MeesCode/esp-doorbell/srd-05vdc-sl-c.stp

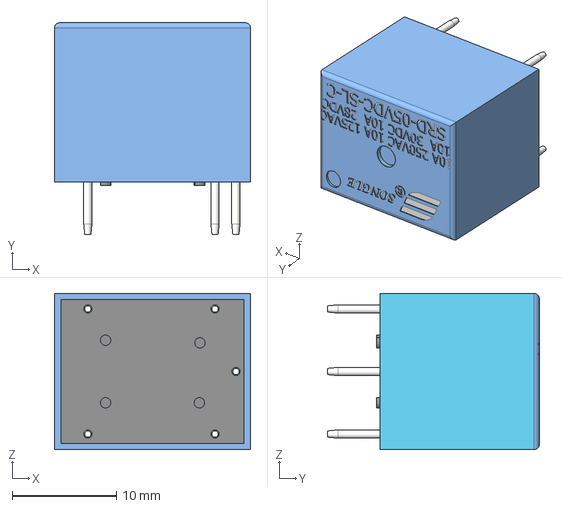
[picture p2: CAD file, 2025-04-24]
srd-05vdc-sl-c.stp
18.8 x 20.3 x 15.0 mm
