MeesCode/esp-doorbell/esp-doorbell.kicad_pcb

## KiCad design esp-doorbell.kicad_pcb (2025-04-26)

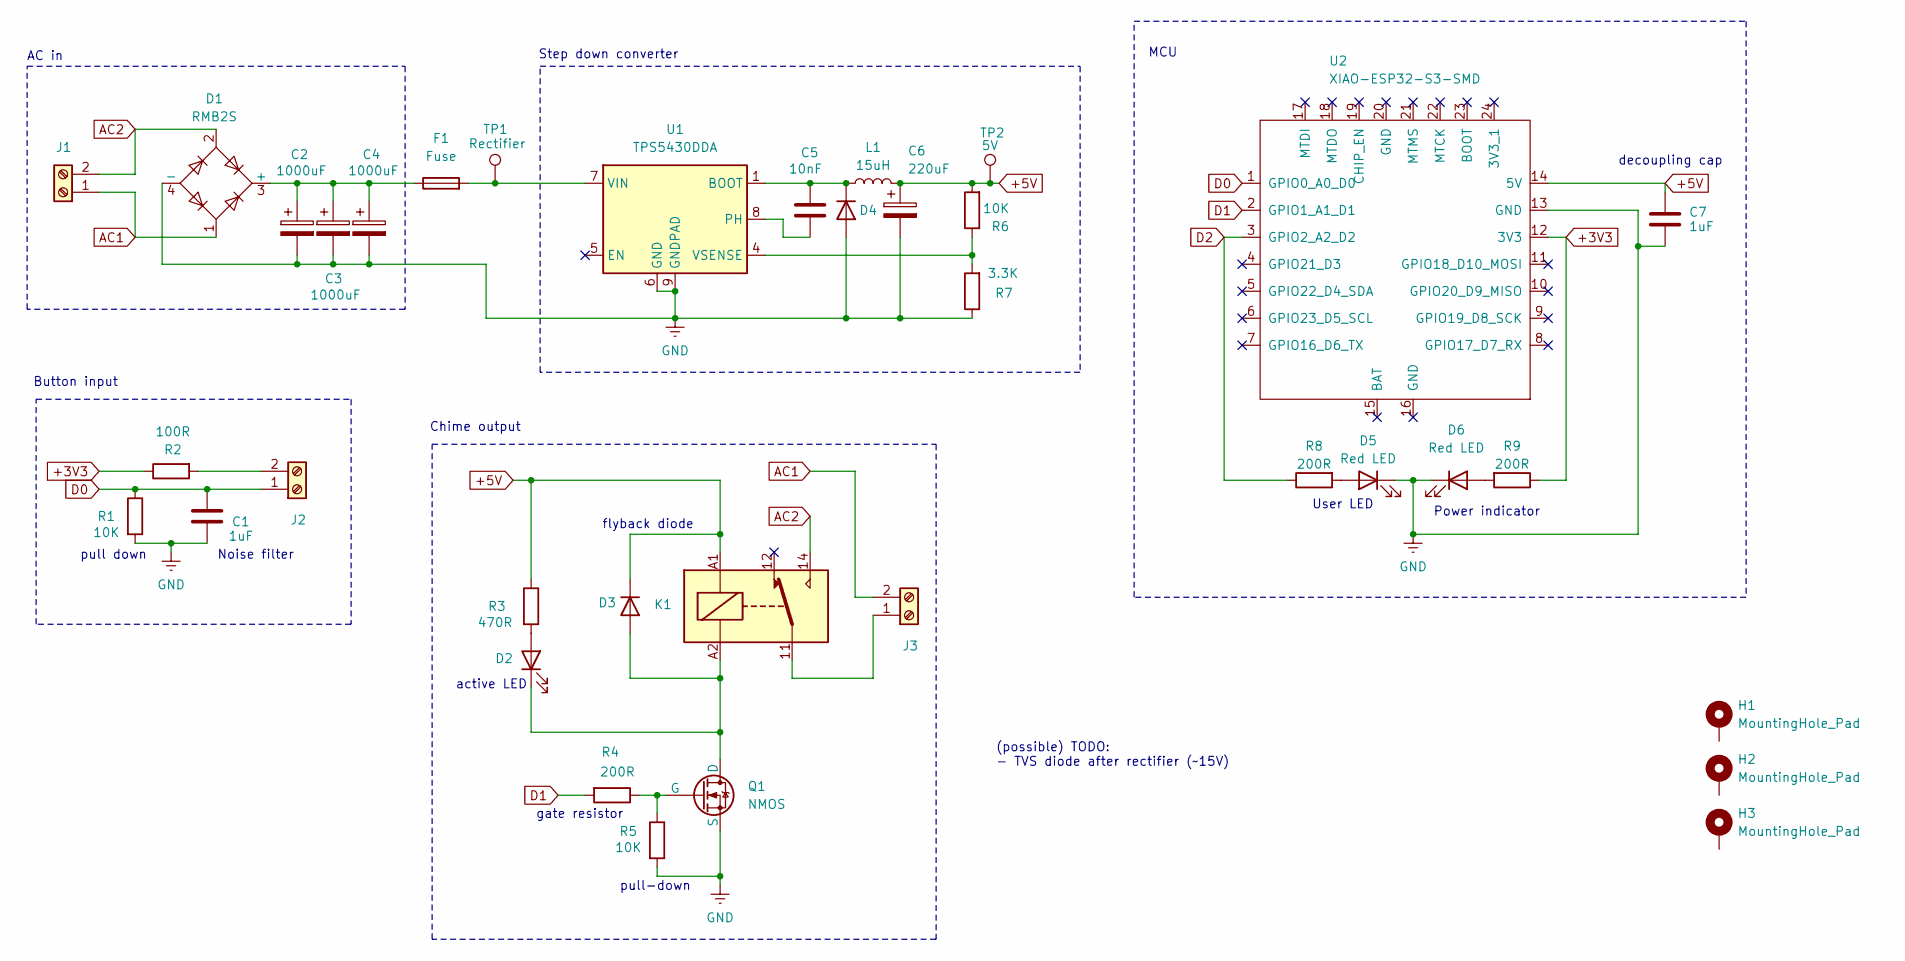
[picture p3: schematic esp-doorbell.kicad_sch]

Parts:
C1, C7: 1uF; C_0402_1005Metric; LCSC C52923
C2, C3, C4: 1000uF; CP_Elec_10x12.5; LCSC C2904877
C5: 10nF; C_0402_1005Metric; LCSC C57112
C6: 220uF; CP_Elec_6.3x7.7; LCSC C3342
D1: RMB2S; TO-269AA; LCSC C2488
D2, D5, D6: Red LED; LED_0603_1608Metric; LCSC C2286
D3: SM4007PL; D_SOD-123F; LCSC C64898
D4: D; D_SMA; Manufacturer # B530C-13-F; LCSC C64982
F1: Fuse; LED_1206_3216Metric; LCSC C720075
H1, H2, H3: MountingHole_Pad; MountingHole_3.2mm_M3_DIN965_Pad
J1, J2, J3: Screw_Terminal_01x02; TerminalBlock_Phoenix_MKDS-1,5-2-5.08_1x02_P5.08mm_Horizont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; LCSC C8465
K1: JQC-3FF-005-1Z; Relay_SPDT_Hongfa_JQC-3FF_0XX-1Z; LCSC C24585
L1: 15uH; L_Changjiang_FNR5040S; LCSC C167969
Q1: NMOS; SOT-23-3; LCSC C20917
R1, R5, R6: 10K; R_0603_1608Metric; LCSC C15401
R2: 100R; R_0603_1608Metric; LCSC C22775
R3: 470R; R_0603_1608Metric; LCSC C23179
R4, R8, R9: 200R; R_0603_1608Metric; LCSC C22962
R7: 3.3K; R_0603_1608Metric; LCSC C22978
TP1: Rectifier; TestPoint_Pad_D1.0mm
TP2: 5V; TestPoint_Pad_D1.0mm
U1: TPS5430DDA; TI_SO-PowerPAD-8_ThermalVias; LCSC C9864
U2: XIAO-ESP32-S3-SMD; XIAO-ESP32C6-SMD

Connections:
+3V3: R2.1, R9.1, U2.12 (3V3)
+5V: C6.1, C7.1, D3.1 (K), K1.A1, L1.2, R3.1, R6.2, TP2.1, U2.14 (5V)
AC1: D1.1, J1.1, J3.2
AC2: D1.2, J1.2, K1.14
D0: C1.1, J2.1, R1.1, U2.1 (GPIO0_A0_D0)
D1: R4.2, U2.2 (GPIO1_A1_D1)
D2: R8.1, U2.3 (GPIO2_A2_D2)
GND: C1.2, C2.2, C3.2, C4.2, C6.2, C7.2, D1.4 (-), D4.2 (A), D5.1 (K), D6.1 (K), Q1.3 (S), R1.2, R5.2, R7.1, U1.6 (GND), U1.9 (GNDPAD), U2.13 (GND)
unnamed: C2.1, C3.1, C4.1, D1.3 (+), F1.1
unnamed: D2.2 (A), R3.2
unnamed: D2.1 (K), D3.2 (A), K1.A2, Q1.1 (D)
unnamed: C5.2, D4.1 (K), L1.1, U1.1 (BOOT)
unnamed: D5.2 (A), R8.2
unnamed: D6.2 (A), R9.2
unnamed: J2.2, R2.2
unnamed: J3.1, K1.11
unnamed: Q1.2 (G), R4.1, R5.1
unnamed: C5.1, U1.8 (PH)
unnamed: F1.2, TP1.1, U1.7 (VIN)
unnamed: R6.1, R7.2, U1.4 (VSENSE)

Notes on the sheet:
active LED
Button input
Noise filter
Chime output
pull down
User LED
AC in
(possible) TODO: - TVS diode after rectifier (~15V)
Power indicator
gate resistor
pull-down
Step down converter
flyback diode
decoupling cap
MCU

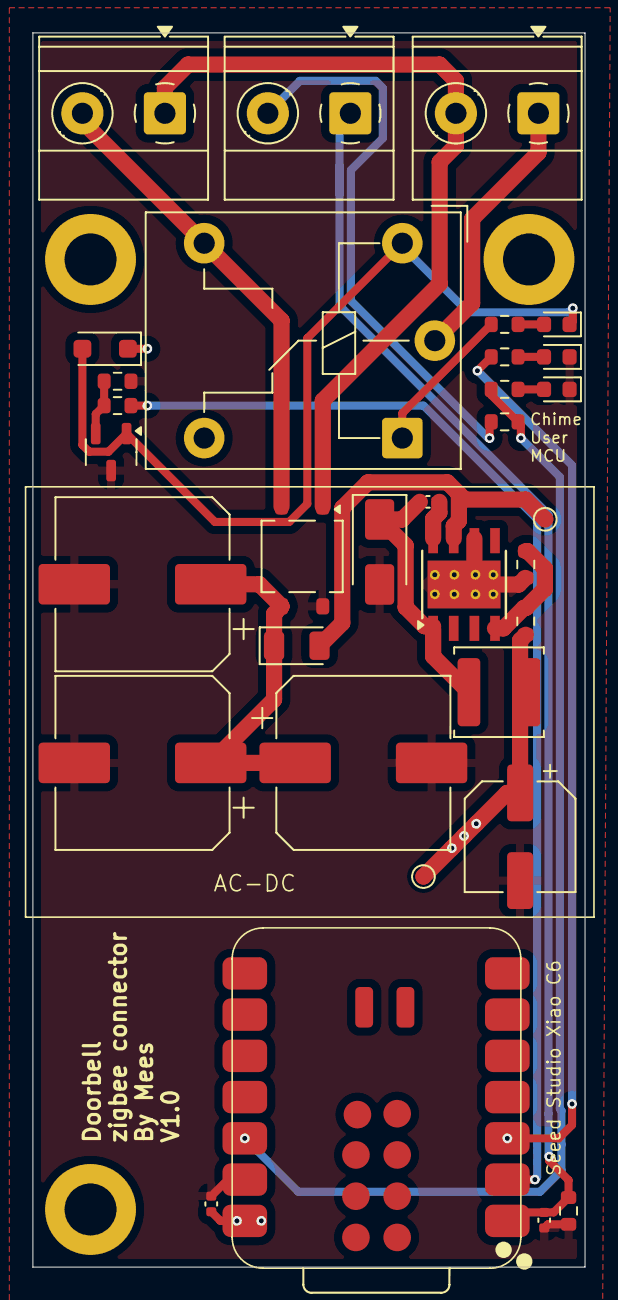
[picture p4: board esp-doorbell.kicad_pcb from above]

Board: 2 copper layers, 34.0 x 76.0 mm, 36 parts (0 on the bottom side), 20 nets.
