MeesCode/esp-doorbell/(commit log)

2025-04-15 initial schematics
    [esp-doorbell.kicad_pcb, esp-doorbell.kicad_sch]
2025-04-24 fix schematics, add layout
    [Seeed Studio XIAO ESP32-C6.step, esp-doorbell.kicad_pcb, esp-doorbell.kicad_sch, srd-05vdc-sl-c.stp]
2025-04-25 make board a bit smaller
    [esp-doorbell.kicad_pcb, esp-doorbell.kicad_sch]
2025-04-25 save changes
    [esp-doorbell.kicad_pcb]
2025-04-26 cleanup, add silkscreen
    [esp-doorbell.kicad_pcb]
